AnvithPothula/HalfLifeWeek5-Custom/ChessClock/production/bom.csv

Designator | Footprint | Quantity | Value | LCSC Part #
C1 | 0805 | 1 | 10u
D1 | D_DO-41_SOD81_P10.16mm_Horizontal | 1 | 1N5819
H1, H2, H3, H4 | MountingHole_3.2mm_M3 | 4 | M3
J1, J2 | PinHeader_1x04_P2.54mm_Vertical | 2 | OLED
J3 | SolderWire-0.25sqmm_1x02_P4.2mm_D0.65mm_OD1.7mm | 1 | Battery
J4 | SolderWire-0.25sqmm_1x02_P4.2mm_D0.65mm_OD1.7mm | 1 | Piezo
JP1, JP2, JP3, JP4 | SolderJumper-3_P1.3mm_Open_RoundedPad1.0x1.5mm | 4 | 3V3 / pin / GND
R1, R2 | R_Axial_DIN0207_L6.3mm_D2.5mm_P10.16mm_Horizontal | 2 | 10k
SW1 | SW_Cherry_MX_1.00u_PCB | 1 | Left
SW2 | SW_Cherry_MX_1.00u_PCB | 1 | Right
SW3 | SW_Cherry_MX_1.00u_PCB | 1 | Minus
SW4 | SW_Cherry_MX_1.00u_PCB | 1 | Start
SW5 | SW_Cherry_MX_1.00u_PCB | 1 | Plus
U1 | Waveshare ESP32-S3-Zero | 1 | Waveshare ESP32-S3-ZERO
