AnvithPothula/HalfLifeWeek5-Custom/JOURNAL.md

# Smart Chess Clock: devlog

<!-- Generated by Half Life from project kpe13lo3e2tpoxkudyga7qa6. Edits here are overwritten on the next sync. -->
<!-- Generated: 2026-11-09T01:50:26.630Z -->

> [!NOTE]
> This devlog is mirrored from [Half Life](https://halflife.hackclub.com) ([open the project](https://halflife.hackclub.com/projects/kpe13lo3e2tpoxkudyga7qa6)). Editing it here will not change the platform's copy, and the next sync overwrites this file.

> A two-player chess clock with OLED screens, MX keys and AA power. It has increment, delay and time-odds modes, plus a Wi-Fi page that exports your game and move times to a Lichess study.

| Week | Tier | Hours logged | Entries |
| --- | --- | --- | --- |
| Week 5 | Tier 1 | 14h | 3 |

## Contents

1. [2026-11-07: I finished the schematic and PCB. This is the final result (I still need to add the designs on the silkscreen):](#2026-11-07-i-finished-the-schematic-and-pcb-this-is-the-fina)
2. [2026-11-08: This session I started the firmware for the chess clock. I’m using Arduino with the ESP32 and the Adafruit SSD1306 library for the two OLED screens. The goal is for it to work like a normal chess cloc](#2026-11-08-this-session-i-started-the-firmware-for-the-chess)
3. [2026-11-08: This session I added game saving, the Wi-Fi page, and the Lichess export. I also worked on the screens and battery life.](#2026-11-08-this-session-i-added-game-saving-the-wi-fi-page-a)

## Design

### 2026-11-07: I finished the schematic and PCB. This is the final result (I still need to add the designs on the silkscreen):

**6h**

I finished the schematic and PCB. This is the final result (I still need to add the designs on the silkscreen):

Screenshot 2026-11-06 at 9.50.12 PM

I am making a chess clock, so I have 2 screens (1 per player), an ESP32, some solder jumpers, MX switches for the buttons, and then some diodes, resistors, capacitors, wire pads, piezo, and a battery holder. This is the schematic of the ESP32:

Screenshot 2026-11-06 at 9.05.41 PM

Everything is connected to that. The next important thing are the screens:

Screenshot 2026-11-06 at 9.06.10 PM

Finally, this is all the boring stuff (in my opinion), to actually make it work:

Screenshot 2026-11-06 at 9.07.45 PM

This is how the schematic looks like with everything. This took a while since there are so many parts (all my other projects were smaller):

Screenshot 2026-11-06 at 9.07.38 PM

Then, I put everything where it should be in the PCB;

Screenshot 2026-11-06 at 9.17.40 PM

Finally, I wired everything up:

Screenshot 2026-11-06 at 9.49.25 PM

Screenshot 2026-11-06 at 9.49.35 PM

Screenshot 2026-11-06 at 9.49.48 PM

Overall, I am proud of how it turned out. Now, all that's left to do is the software.

### 2026-11-08: This session I started the firmware for the chess clock. I’m using Arduino with the ESP32 and the Adafruit SSD1306 library for the two OLED screens. The goal is for it to work like a normal chess cloc

**4h**

This session I started the firmware for the chess clock. I’m using Arduino with the ESP32 and the Adafruit SSD1306 library for the two OLED screens. The goal is for it to work like a normal chess clock (so each player has a key on their side, and pressing it stops your clock and starts the other player’s).

First I matched the pins to my schematic. Both OLEDs have the same I2C address (0x3C), so they can’t share one bus. Also, I put the left screen on Wire (GPIO 4 and 5) and the right screen on Wire1 (GPIO 6 and 7).

Screenshot 2026-11-08 at 10.04.12 AM

Next I added the time controls. There are 9 presets from Bullet 1+0 to Classic 30+0, and the - and + keys cycle through them before a game. There’s also a Custom setting where White and Black can have different times (time odds), and you can pick increment or delay mode. Also, all of the settings are saved with Preferences, so that they stay after the clock turns off.

Screenshot 2026-11-08 at 10.24.41 AM

The player keys were the most important part, since a chess clock has to be exact. If I only checked the keys in loop(), a press could be missed or counted late while the screens are being redrawn. To fix this, the two player keys use interrupts, and the interrupt saves the exact time of the press. Also, I made it so that any change within 30 ms of a release is ignored as a bounce.

Screenshot 2026-11-08 at 10.25.10 AM

Then I wrote the clock logic. advanceClock() subtracts the time that passed from the player whose turn it is. In delay mode, the delay runs out before the main time starts going down. When a player drops under 10 seconds the clock double beeps, and when their time hits 0 it beeps for 1.5 seconds and ends the game. endTurn() uses the time from the interrupt instead of the current time and then adds the increment, saves that player’s clock time for the move, and switches turns.

Screenshot 2026-11-08 at 10.26.34 AM

Finally, I set up the Start, -, and + keys. Before a game, Start begins it (Black can also start it by pressing their key), and holding Start opens the settings menu. During a game, Start pauses, and holding it while paused ends the game.

Screenshot 2026-11-08 at 10.29.37 AM

In the next session, I plan on finishing the software part.

### 2026-11-08: This session I added game saving, the Wi-Fi page, and the Lichess export. I also worked on the screens and battery life.

**4h**

This session I added game saving, the Wi-Fi page, and the Lichess export. I also worked on the screens and battery life.

Every game is saved with the starting times, the result, and the clock time after each move (up to 300). The clock keeps the last 5 games. Each game gets a number, and that number decides which of the 5 slots it goes into, so the newest game always replaces the oldest one.

Screenshot 2026-11-08 at 10.35.17 AM

To open the Wi-Fi page, you hold Start after a game or pick Wi-Fi games in the menu. The clock connects to my Wi-Fi and shows its IP address on the left screen. Opening that address in a browser shows the saved games. The clock only knows the times, not the moves, so on the page you play the moves on a board, and it builds the PGN with the clock time for each move. /api/games lists the games, and /api/game sends one game’s clock times as JSON.

Screenshot 2026-11-08 at 10.35.39 AM

For the export, the page sends the PGN to the clock, and the clock sends it to the Lichess study API with my token. It checks the study ID and the PGN size first. My Wi-Fi password and Lichess token are in secrets.h, which is in .gitignore.

Screenshot 2026-11-08 at 10.36.06 AM

For the screens, buildScreen() decides what each screen shows in each state. During a game, the player whose turn it is gets a highlighted bar at the top, and the time switches to tenths of a second under 20 seconds. To stop flicker, drawScreens() only redraws a screen when something on it changed.

Screenshot 2026-11-08 at 10.36.36 AM

Since the clock runs on 3 AA batteries, I lowered the CPU to 80 MHz and added deep sleep. If nothing happens for 5 minutes and no game is running, the screens turn off and the ESP32 sleeps. Pressing either player key or Start wakes it up. The battery level is read through the 10k/10k divider and shown in the corner of the right screen.

Screenshot 2026-11-08 at 10.36.53 AM

Now, all that's left is to test it during the build week!
