AnvithPothula/HalfLifeWeek5-Custom/ChessClock/ChessClock.kicad_pcb

## KiCad design ChessClock/ChessClock.kicad_pcb (2026-11-09)

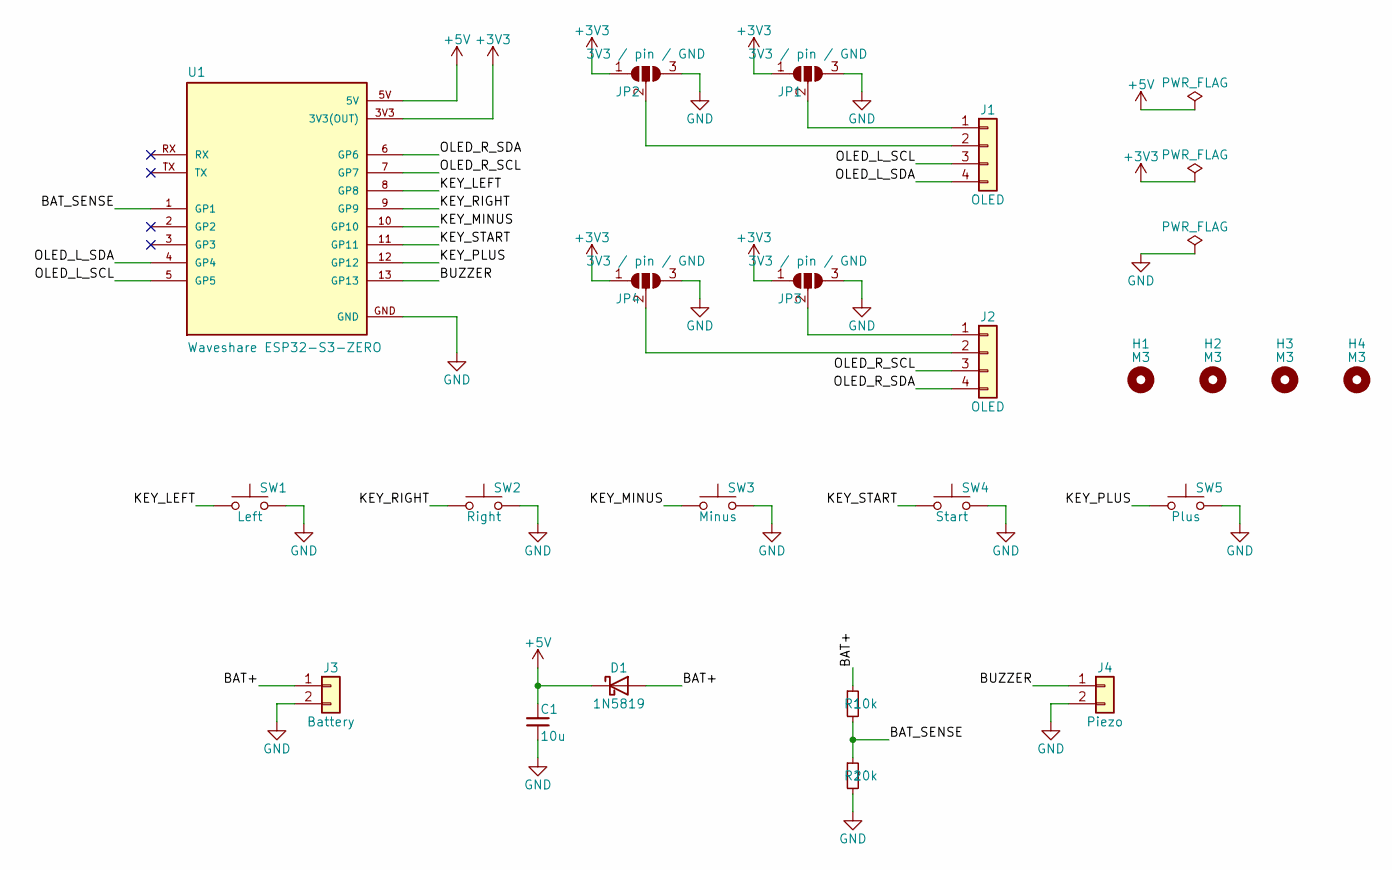
[picture p9: schematic ChessClock.kicad_sch]

Parts:
C1: 10u; C_0805_2012Metric
D1: 1N5819; D_DO-41_SOD81_P10.16mm_Horizontal
H1, H2, H3, H4: M3; MountingHole_3.2mm_M3
J1, J2: OLED; PinHeader_1x04_P2.54mm_Vertical
J3: Battery; SolderWire-0.25sqmm_1x02_P4.2mm_D0.65mm_OD1.7mm
J4: Piezo; SolderWire-0.25sqmm_1x02_P4.2mm_D0.65mm_OD1.7mm
JP1, JP2, JP3, JP4: 3V3 / pin / GND; SolderJumper-3_P1.3mm_Open_RoundedPad1.0x1.5mm
R1, R2: 10k; R_Axial_DIN0207_L6.3mm_D2.5mm_P10.16mm_Horizontal
SW1: Left; SW_Cherry_MX_1.00u_PCB
SW2: Right; SW_Cherry_MX_1.00u_PCB
SW3: Minus; SW_Cherry_MX_1.00u_PCB
SW4: Start; SW_Cherry_MX_1.00u_PCB
SW5: Plus; SW_Cherry_MX_1.00u_PCB
U1: Waveshare ESP32-S3-ZERO; Waveshare ESP32-S3-Zero; PARTREV NA

Connections:
+3V3: JP1.1 (A), JP2.1 (A), JP3.1 (A), JP4.1 (A), U1.3V3 (3V3(OUT))
+5V: C1.1, D1.1 (K), U1.5V
/BAT+: D1.2 (A), J3.1, R1.1
/BAT_SENSE: R1.2, R2.1, U1.1 (GP1)
/BUZZER: J4.1, U1.13 (GP13)
/KEY_LEFT: SW1.1, U1.8 (GP8)
/KEY_MINUS: SW3.1, U1.10 (GP10)
/KEY_PLUS: SW5.1, U1.12 (GP12)
/KEY_RIGHT: SW2.1, U1.9 (GP9)
/KEY_START: SW4.1, U1.11 (GP11)
/OLED_L_SCL: J1.3, U1.5 (GP5)
/OLED_L_SDA: J1.4, U1.4 (GP4)
/OLED_R_SCL: J2.3, U1.7 (GP7)
/OLED_R_SDA: J2.4, U1.6 (GP6)
GND: C1.2, J3.2, J4.2, JP1.3 (B), JP2.3 (B), JP3.3 (B), JP4.3 (B), R2.2, SW1.2, SW2.2, SW3.2, SW4.2, SW5.2, U1.GND
unnamed: J1.1, JP1.2 (C)
unnamed: J1.2, JP2.2 (C)
unnamed: J2.1, JP3.2 (C)
unnamed: J2.2, JP4.2 (C)

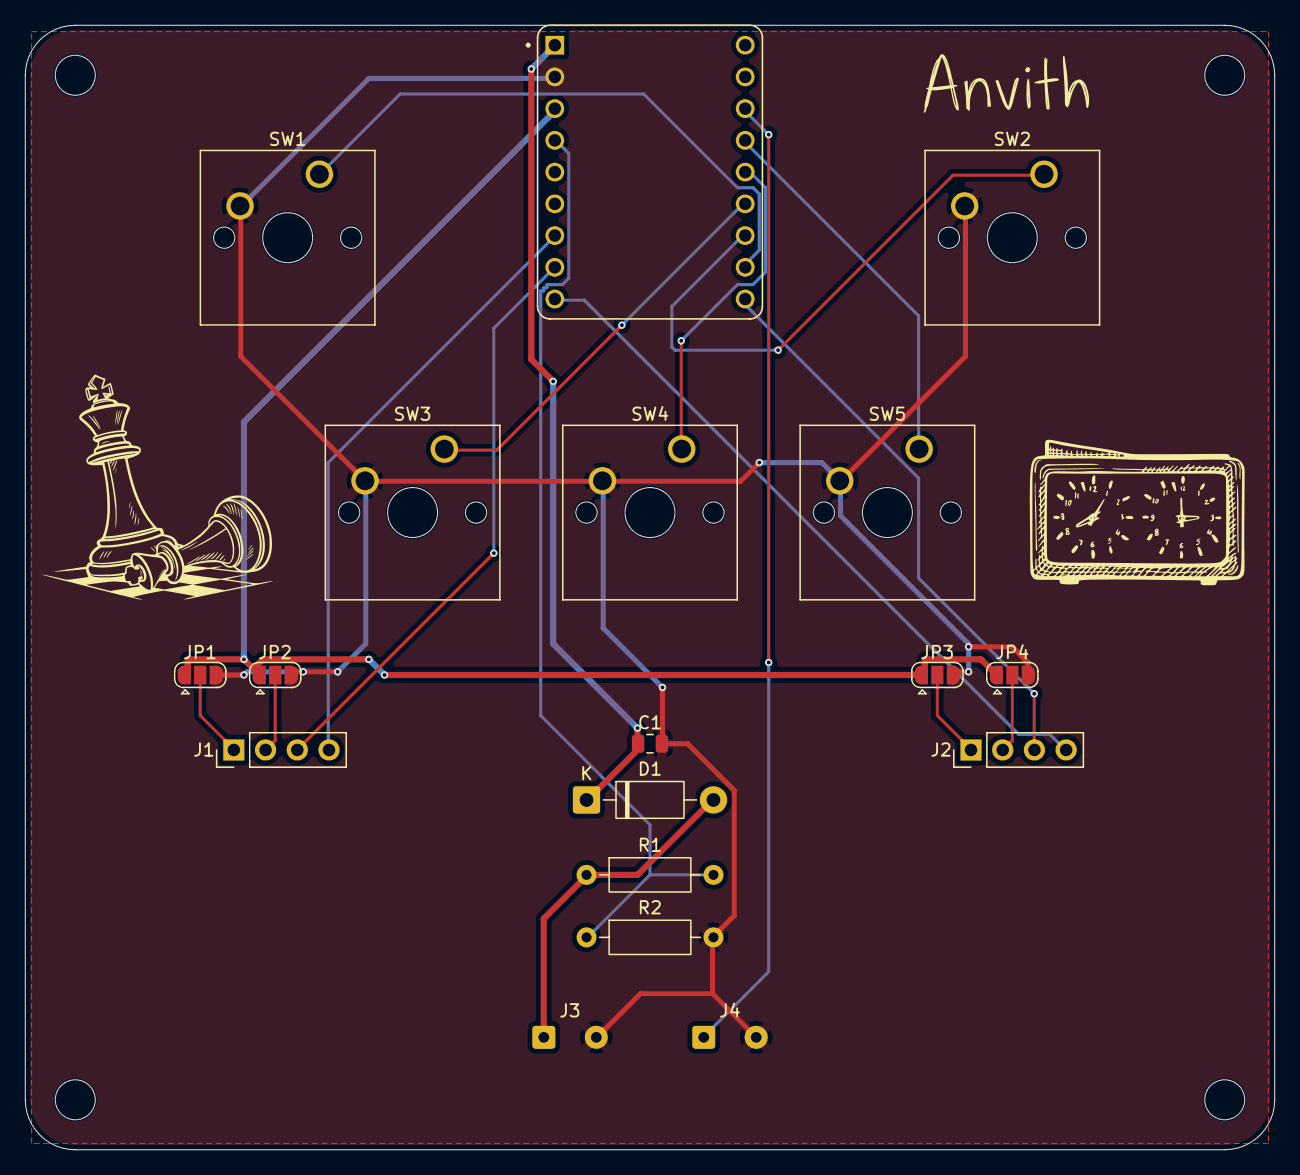
[picture p10: board ChessClock.kicad_pcb from above]

Board: 2 copper layers, 100.0 x 90.0 mm, 22 parts (0 on the bottom side), 19 nets.
