AnvithPothula/HalfLifeWeek5-Custom/ChessClockArduino/secrets_example.h

#pragma once

#define WIFI_SSID "your-wifi-name"
#define WIFI_PASSWORD "your-wifi-password"

// study:write
// https://lichess.org/account/oauth/token/create?scopes[]=study:write&description=Chess+Clock
#define LICHESS_TOKEN ""
