AnvithPothula/HalfLifeWeek5-Custom/(commit log)

2026-11-03 Sync Smart Chess Clock from Half Life
    [BOM.csv]
2026-11-09 Finished week 5
    [BOM.csv, ChessClock.kicad_pcb, ChessClock.kicad_sch, bom.csv, designators.csv, positions.csv]
2026-11-10 Updated BOM
    [BOM.csv]
2026-11-12 Revert "Updated BOM"
    This reverts commit ca56e541571713984534c05d8865310d46215038.
    [BOM.csv]
